usimd/stm32-sensor-platform/images/r1_bot.png

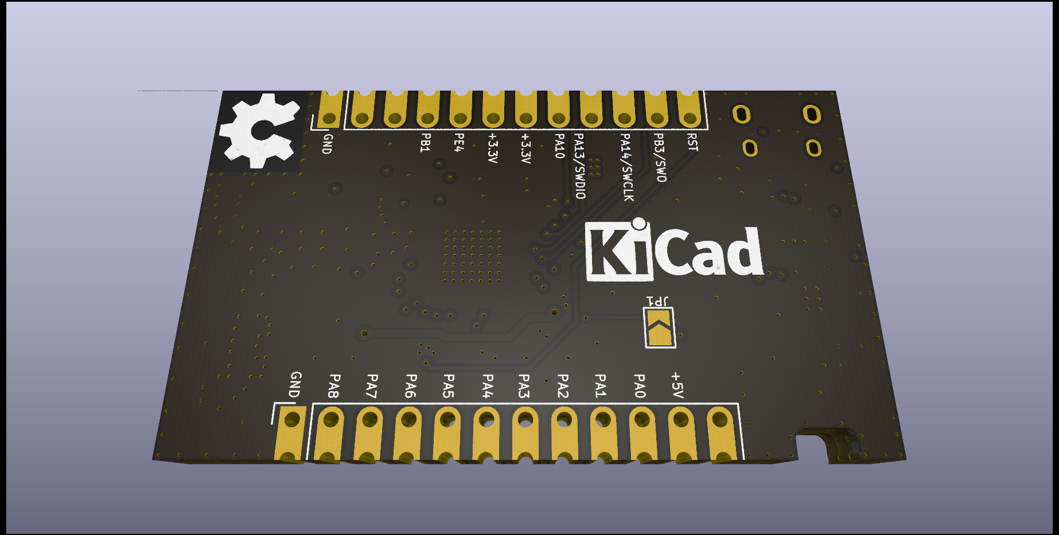
images/r1_bot.png
