usimd/stm32-sensor-platform/images/r1_top.png

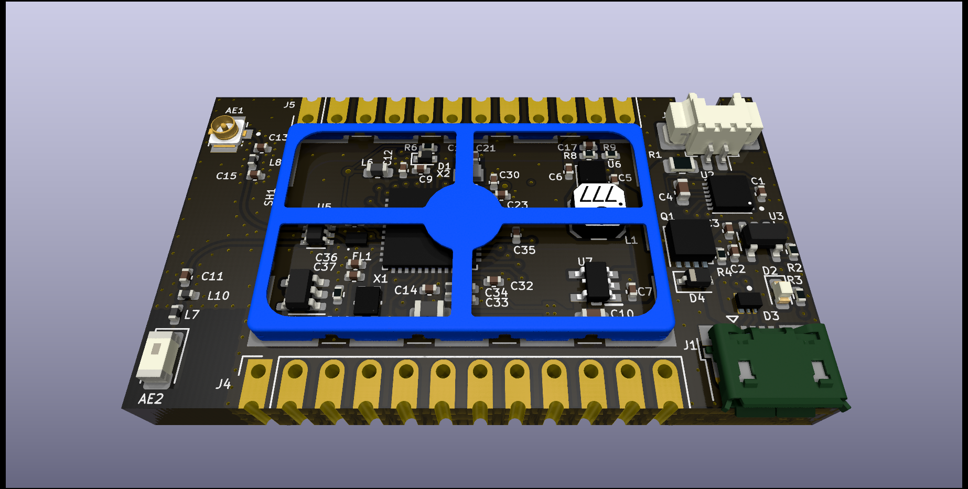
images/r1_top.png
