usimd/stm32-sensor-platform/README.md

# stm32-sensor-platform
Extensible BLE/OpenThread sensor module based on STM32 for integration with HomeAssistant
