usimd/stm32-sensor-platform/sensor.kicad_pcb

## KiCad design sensor.kicad_pcb (2022-10-17)

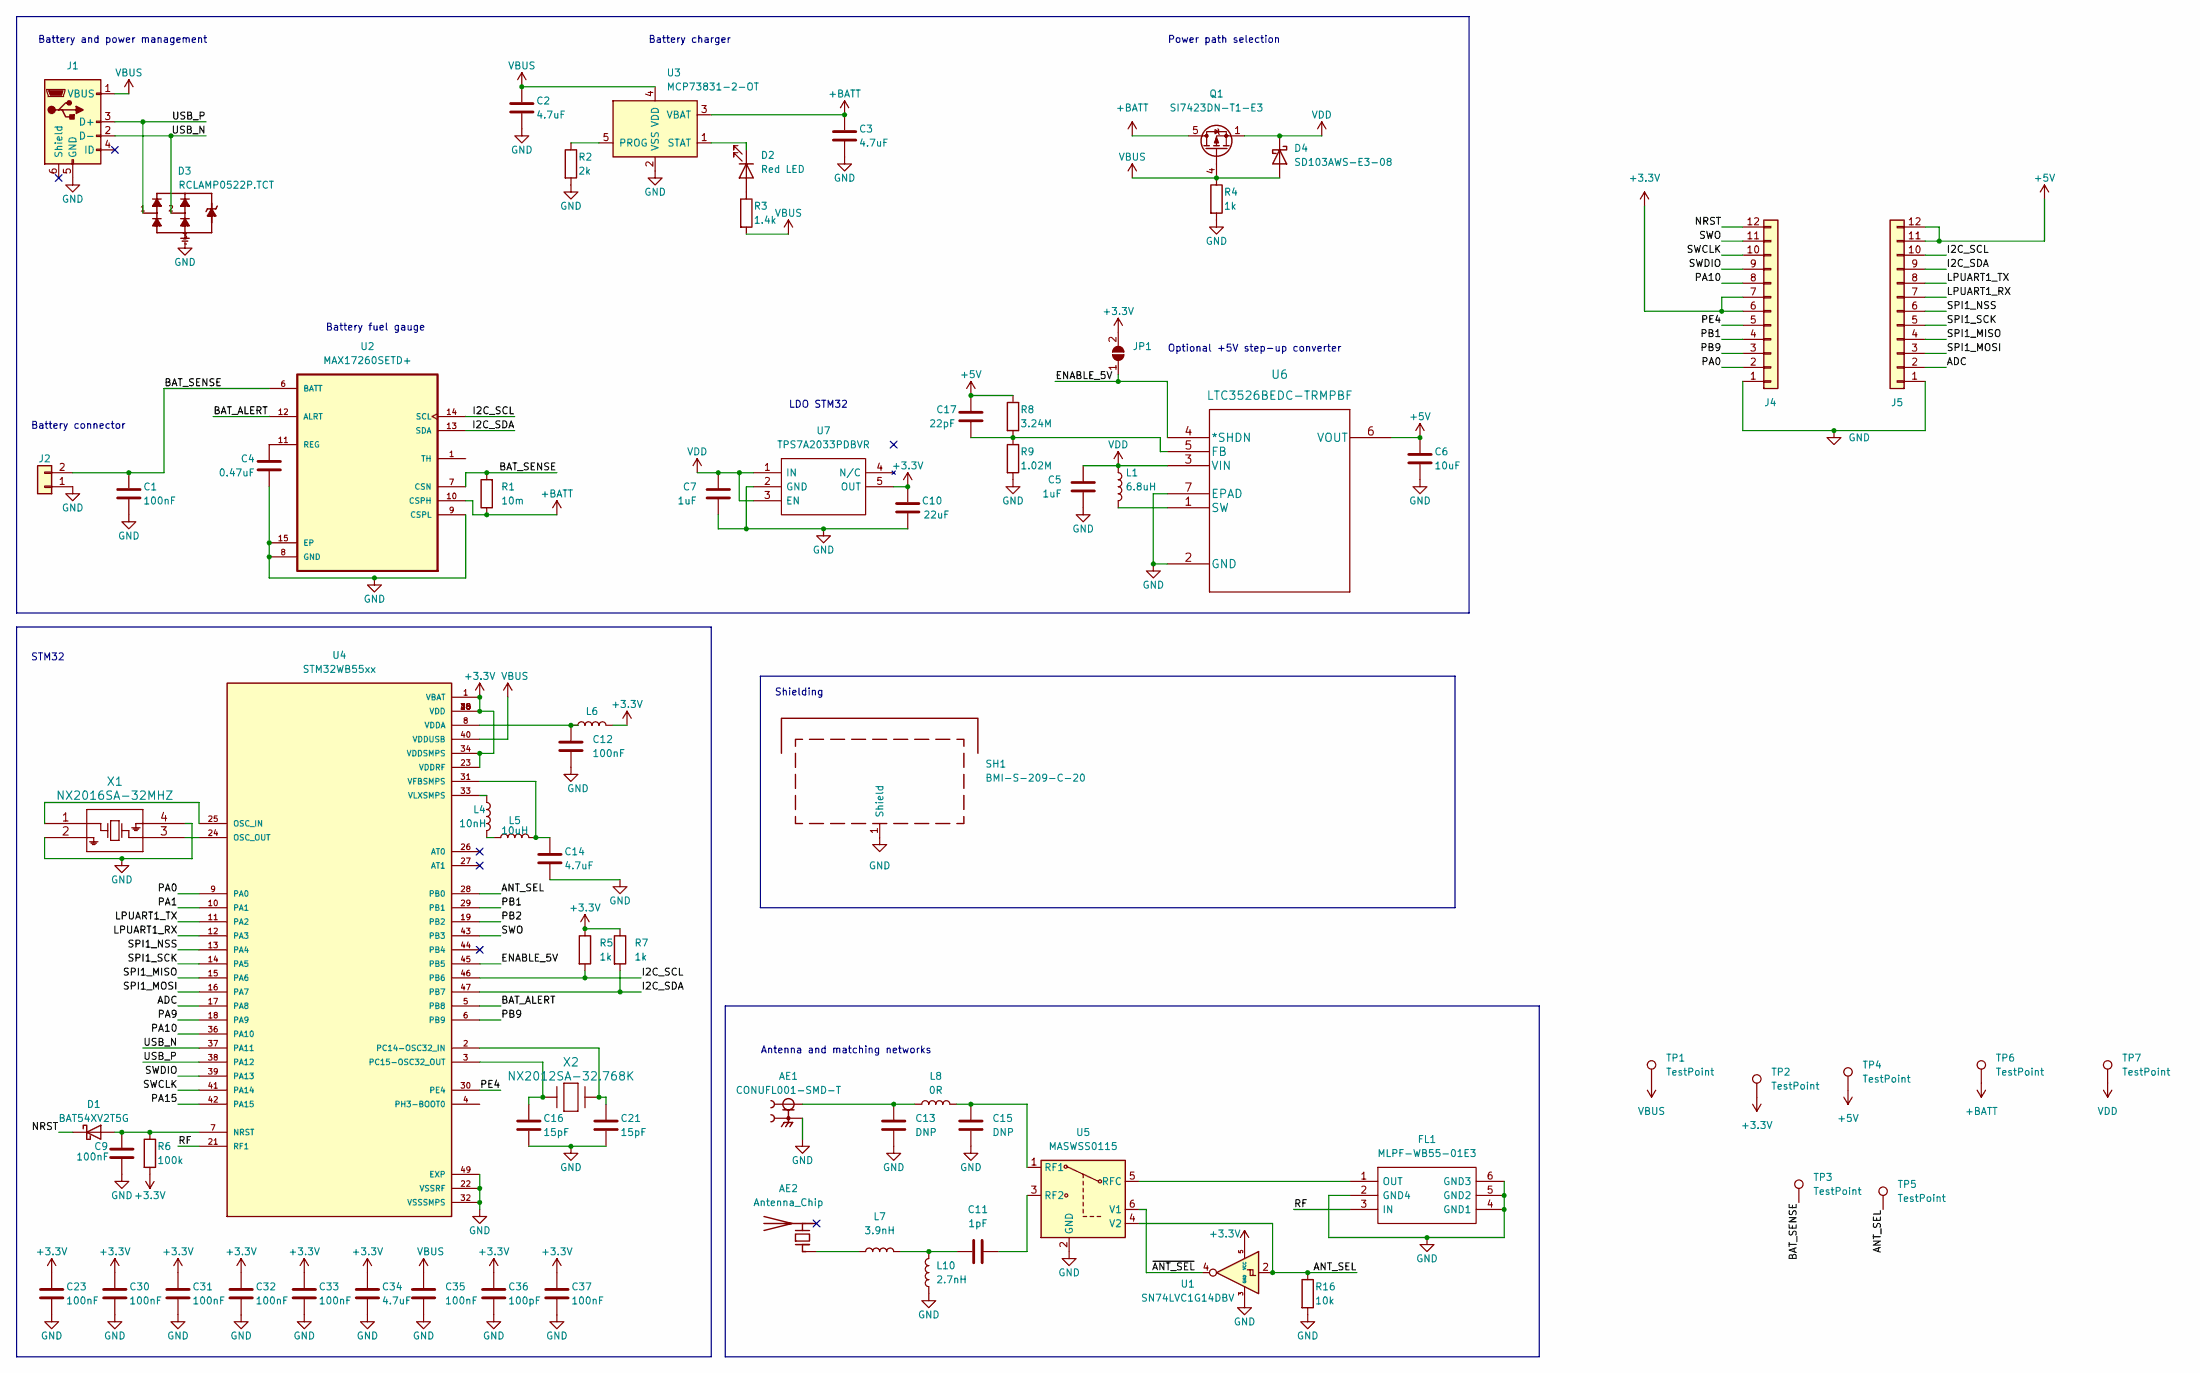
[picture p3: schematic sensor.kicad_sch, Wireless sensor]

Parts:
AE1: CONUFL001-SMD-T; LINX_CONUFL001-SMD-T; PARTREV B
AE2: Antenna_Chip; Johanson_2450AT18x100; MPN 2450AT18A100E
C1: 100nF; C_0402_1005Metric; MPN GRM155R62A104KE14J
C2, C3, C14, C34: 4.7uF; C_0402_1005Metric; MPN GRM155R61A475MEAAD
C4: 0.47uF; C_0603_1608Metric; MPN LMK063BBJ474KPLF
C5, C7: 1uF; C_0402_1005Metric; MPN CL05A105KP5NNNC
C6: 10uF; C_0603_1608Metric; MPN 0603ZD106KAT2A
C9, C12, C23, C30, C31, C32, C33, C35, C37: 100nF; C_0402_1005Metric; MPN GRM155R61H104KE19D
C10: 22uF; C_0603_1608Metric; MPN CL10A226KQ8NRNE
C11: 1pF; C_0402_1005Metric; MPN 500R07S1R0BV4T
C13, C15: DNP; C_0402_1005Metric
C16, C21: 15pF; C_0402_1005Metric; MPN GRM1555C1H4R3CA01D
C17: 22pF; C_0402_1005Metric; MPN C0402C220K4RACTU
C36: 100pF; C_0402_1005Metric; MPN CC0402KRX7R9BB101
D1: BAT54XV2T5G; D_SOD-523; MPN BAT54XV2T5G
D2: Red LED; LED_0603_1608Metric; MPN LS L29K-G1J2-1
D3: RCLAMP0522P.TCT; TVS_RCLAMP0522P.TCT; MPN RCLAMP0522P.TCT
D4: SD103AWS-E3-08; D_SOD-323; MPN SD103AWS-E3-08
FL1: MLPF-WB55-01E3; MLPFWB5501E3; Manufacturer_Part_Number MLPF-WB55-01E3; Mouser Part Number 511-MLPF-WB55-01E3
J1: 10103594-0001LF; USB_Micro-B_Amphenol_10103594-0001LF_Horizontal; MPN 10103594-0001LF
J2: Molex_PicoBlade_53261-0271_1x02-1MP_P1.25mm_Horizontal; MPN 53261-7002
J4, J5: Castellation_1x12_Drill
JP1: SolderJumper-2_P1.3mm_Open_TrianglePad1.0x1.5mm
L1: 6.8uH; L_Coilcraft_LPS4018; MPN LPS4018-682MRC
L4: 10nH; L_0402_1005Metric; MPN LQG15WZ10NJ02D
L5: 10uH; L_0805_2012Metric; MPN LQM21FN100M70L
L6: L_0603_1608Metric; MPN MMZ1608S601ATA00
L7: 3.9nH; L_0402_1005Metric; MPN L-07C3N9SV6T
L8: 0R; L_0402_1005Metric; MPN RC0402JR-100RL
L10: 2.7nH; L_0402_1005Metric; MPN L-07C2N7SV6T
Q1: SI7423DN-T1-E3; Vishay_PowerPAK_1212-8_Single; MPN SI7423DN-T1-E3
R1: 10m; R_0805_2012Metric; MPN ERJ-6CWDR010V
R2: 2k; R_0402_1005Metric; MPN ERJ-2RHD2001X
R3: 1.4k; R_0402_1005Metric; MPN ERJ-2RHD1401X
R4, R5, R7: 1k; R_0402_1005Metric; MPN RGC1/16SC1001DTH
R6: 100k; R_0402_1005Metric; MPN RC0402FR-10100KL
R8: 3.24M; R_0805_2012Metric; MPN RS73F2ATTD3244D
R9: 1.02M; R_0402_1005Metric; MPN CRCW04021M02FKED
R16: 10k; R_0402_1005Metric; MPN CRCW040210K0FKEDC
SH1: BMI-S-209-C-20; Laird_Technologies_BMI-S-209-F_29.36x18.50mm; MPN BMI-S-209-C-20
TP1, TP2, TP3, TP4, TP5, TP6, TP7: TestPoint; TestPoint_Pad_D1.0mm
U1: SN74LVC1G14DBV; SOT-23-5; MPN SN74LVC1G14DBV
U2: MAX17260SETD+; SON40P300X300X80-15N; MPN MAX17260SETD+
U3: MCP73831-2-OT; SOT-23-5; MPN MCP73831T-2ACI/OT
U4: STM32WB55xx; QFN50P700X700X60-49N; PARTREV 5
U5: MASWSS0115; SOT-363_SC-70-6; MPN MASWSS0115TR-3000
U6: LTC3526BEDC-TRMPBF; MPN LTC3526BEDC-TRMPBF
U7: TPS7A2033PDBVR; SOT95P280X145-5N; Manufacturer_Part_Number TPS7A2033PDBVR; Mouser Part Number 595-TPS7A2033PDBVR
X1: NX2016SA-32MHZ; NX2016SA-32MHZ-EXS00A-CS11213; MPN NX2016SA-32M-EXS00A-CS06465
X2: NX2012SA-32.768K; NX2012SA-32.768K-STD-MUB-1; MPN NX2012SA-32.768K-STD-MUB-1

Connections:
+3.3V: C10.1, C23.1, C30.1, C31.1, C32.1, C33.1, C34.1, C36.1, C37.1, J4.6, J4.7, JP1.2 (B), L6.2, R5.1, R6.2, R7.1, TP2.1, U1.5 (VCC), U4.1 (VBAT), U4.20 (VDD), U4.23 (VDDRF), U4.34 (VDDSMPS), U4.35 (VDD), U4.48 (VDD), U7.5 (OUT)
+5V: C6.1, C17.1, J5.11, J5.12, R8.1, TP4.1, U6.6 (VOUT)
+BATT: C3.1, Q1.5 (D), R1.1, TP6.1, U2.10 (CSPH), U3.3 (VBAT)
/ADC: J5.2, U4.17 (PA8)
/ANT_SEL: R16.1, TP5.1, U1.2, U4.28 (PB0), U5.4 (V2)
/BAT_ALERT: U2.12 (ALRT), U4.5 (PB8)
/BAT_SENSE: C1.1, J2.2, R1.2, TP3.1, U2.6 (BATT), U2.7 (CSN)
/ENABLE_5V: JP1.1 (A), U4.45 (PB5), U6.4 (*SHDN)
/I2C_SCL: J5.10, R5.2, U2.14 (SCL), U4.46 (PB6)
/I2C_SDA: J5.9, R7.2, U2.13 (SDA), U4.47 (PB7)
/LPUART1_RX: J5.7, U4.12 (PA3)
/LPUART1_TX: J5.8, U4.11 (PA2)
/NRST: D1.1 (K), J4.12
/PA0: J4.2, U4.9 (PA0)
/PA1: U4.10 (PA1)
/PA9: U4.18 (PA9)
/PA10: J4.8, U4.36 (PA10)
/PA15: U4.42 (PA15)
/PB1: J4.4, U4.29 (PB1)
/PB2: U4.19 (PB2)
/PB9: J4.3, U4.6 (PB9)
/PE4: J4.5, U4.30 (PE4)
/RF: FL1.3 (IN), U4.21 (RF1)
/SPI1_MISO: J5.4, U4.15 (PA6)
/SPI1_MOSI: J5.3, U4.16 (PA7)
/SPI1_NSS: J5.6, U4.13 (PA4)
/SPI1_SCK: J5.5, U4.14 (PA5)
/SWCLK: J4.10, U4.41 (PA14)
/SWDIO: J4.9, U4.39 (PA13)
/SWO: J4.11, U4.43 (PB3)
/USB_N: D3.2, J1.2 (D-), U4.37 (PA11)
/USB_P: D3.1, J1.3 (D+), U4.38 (PA12)
/~ANT_SEL: U1.4, U5.6 (V1)
GND: AE1.2, AE1.3, C1.2, C2.2, C3.2, C4.2, C5.1, C6.2, C7.1, C9.2, C10.2, C12.2, C13.2, C14.2, C15.2, C16.2, C21.2, C23.2, C30.2, C31.2, C32.2, C33.2, C34.2, C35.2, C36.2, C37.2, D3.3, FL1.2 (GND4), FL1.4 (GND1), FL1.5 (GND2), FL1.6 (GND3), J1.5 (GND), J2.1, J4.1, J5.1, L10.1, R2.2, R4.2, R9.2, R16.2, SH1.1 (Shield), U1.3 (GND), U2.8 (GND), U2.9 (CSPL), U2.15 (EP), U3.2 (VSS), U4.22 (VSSRF), U4.32 (VSSSMPS), U4.49 (EXP), U5.2 (GND), U6.2 (GND), U6.7 (EPAD), U7.2 (GND), X1.2, X1.4
unnamed: AE1.1, C13.1, L8.1
unnamed: AE2.1 (FEED), L7.1
unnamed: C4.1, U2.11 (REG)
unnamed: C9.1, D1.2 (A), R6.1, U4.7 (NRST)
unnamed: C11.1, L7.2, L10.2
unnamed: C11.2, U5.3 (RF2)
unnamed: C12.1, L6.1, U4.8 (VDDA)
unnamed: C14.1, L5.2, U4.31 (VFBSMPS)
unnamed: C15.1, L8.2, U5.1 (RF1)
unnamed: C16.1, U4.3 (PC15-OSC32_OUT), X2.2
unnamed: C17.2, R8.2, R9.1, U6.5 (FB)
unnamed: C21.1, U4.2 (PC14-OSC32_IN), X2.1
unnamed: D2.1 (K), U3.1 (STAT)
unnamed: D2.2 (A), R3.1
unnamed: FL1.1 (OUT), U5.5 (RFC)
unnamed: L1.2, U6.1 (SW)
unnamed: L4.1, U4.33 (VLXSMPS)
unnamed: L4.2, L5.1
unnamed: R2.1, U3.5 (PROG)
unnamed: U4.24 (OSC_OUT), X1.3
unnamed: U4.25 (OSC_IN), X1.1
VBUS: C2.1, C35.1, D4.2 (A), J1.1 (VBUS), Q1.4 (G), R3.2, R4.1, TP1.1, U3.4 (VDD), U4.40 (VDDUSB)
VDD: C5.2, C7.2, D4.1 (K), L1.1, Q1.1 (S), Q1.2 (S), Q1.3 (S), TP7.1, U6.3 (VIN), U7.1 (IN), U7.3 (EN)

Notes on the sheet:
STM32
Power path selection
LDO STM32
Shielding
Battery charger
Battery connector
Battery and power management
Battery fuel gauge
Optional +5V step-up converter
Antenna and matching networks

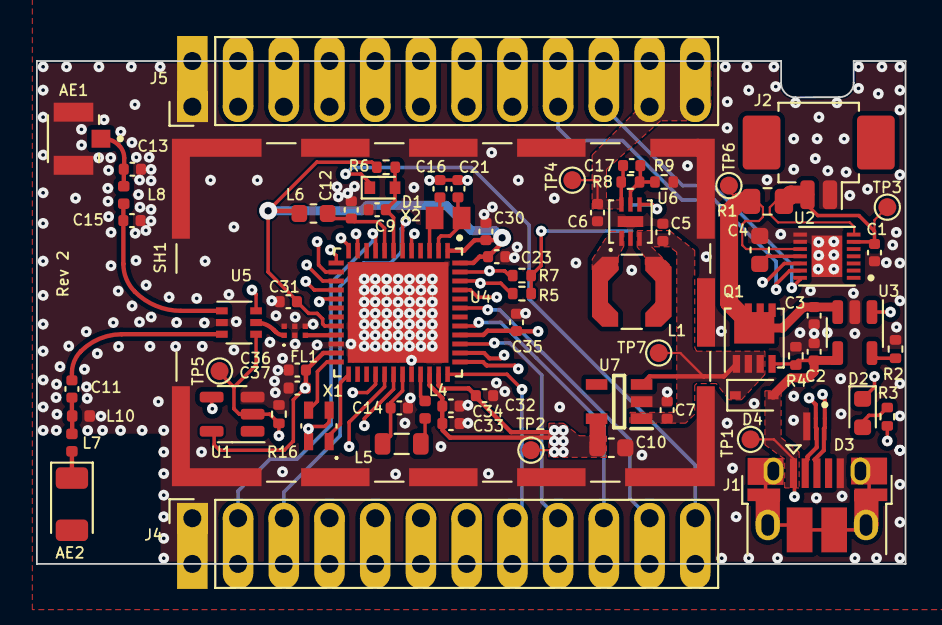
[picture p4: board sensor.kicad_pcb from above]

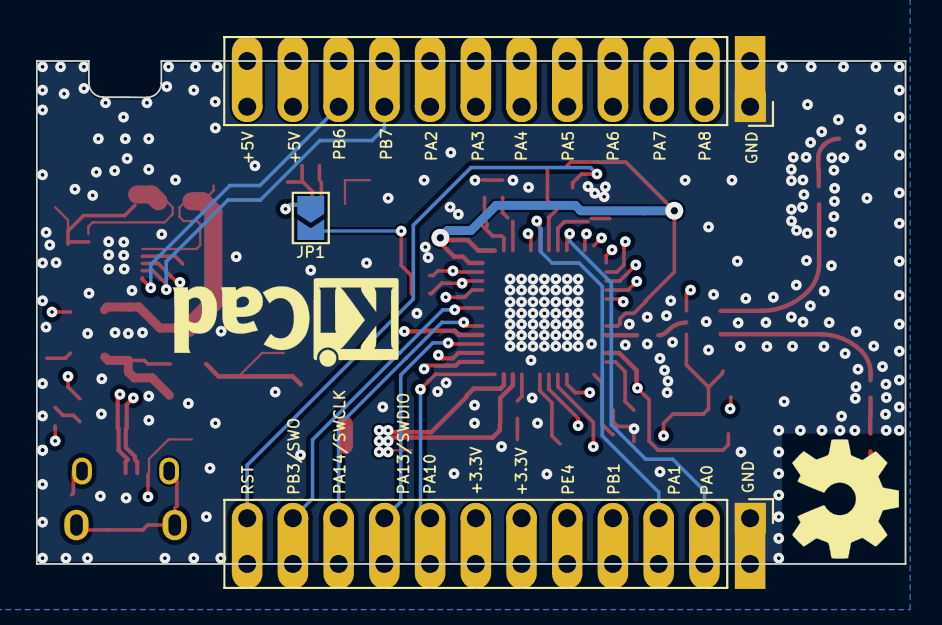
[picture p5: board sensor.kicad_pcb from below]

Board: 4 copper layers, 48.3 x 27.9 mm, 73 parts (2 on the bottom side), 53 nets.
