usimd/stm32-sensor-platform/(commit log)

2022-09-30 Initial import
    [sensor.kicad_pcb, sensor.kicad_sch]
2022-10-02 First full draft
    [sensor.kicad_pcb, sensor.kicad_sch]
2022-10-17 Added I2C ports, rev2
    [sensor.kicad_pcb, sensor.kicad_sch]
